Edzelf/RAK831-LoRa-gateway/README.md

# RAK831-Lora-gateway
LoRa TTN gateway with Orange Pi Zero and RAK831

This project describes how to make a TTN LoRa gateway with a RAK831 and an Orange Pi Zero running Armbian 5.38 (Armbian Stretch).
